xdylanm/low-pass-gate/README.md

# Low Pass Gate

Buchla-style VCA and Sallen-Key VCF with vactrols.
