xdylanm/low-pass-gate/docs/index.md

# Low Pass Gate

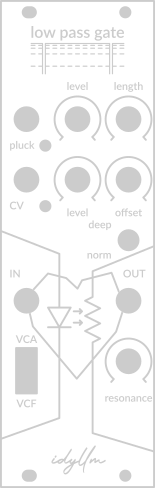
[picture p11: docs/assets/images/lpg-dark.png]

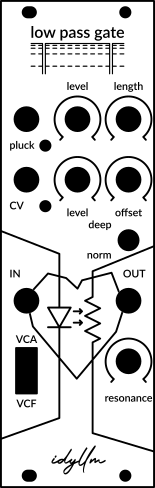
[picture p12: docs/assets/images/lpg-light.png]


Buchla-style VCA and Sallen-Key VCF with vactrols.

* Module size: 6HP (30mm)
* Power: 12mA (+12V); 12mA (-12V)

!!! repository "Project Source"

    The project files, including schematic and layout, are available on [github](https://github.com/xdylanm/low-pass-gate).

## Features

* Pluck input with manual controls for length and level
* CV input with manual controls for level and offset
* Resonance

## Documentation

* [Design](theory.md)
* [Assembly Guide](assembly.md)
* [Schematic](assets/lpg.pdf)

## References

1. A. Lanterman, "ECE4450 L27: Buchla Lowpass Gate," [Youtube](https://www.youtube.com/watch?v=NGz3dDnoVVk) (retrieved Sept. 2024)
2. E. Bergman, "Synthesizer Build Part 35 - Resonant Lopass Gate," [eddybergman.com](https://www.eddybergman.com/2020/10/synthesizer-build-part-35-resonant.html) (retrieved Sept. 2024)
3. T. White, "Resonant Lopass Gate Circuit Board Project," [naturalrhythmmusic.com](https://naturalrhythmmusic.com/lopass) (retrieved Sept. 2024)
