xdylanm/low-pass-gate/docs/assets/lpg.pdf

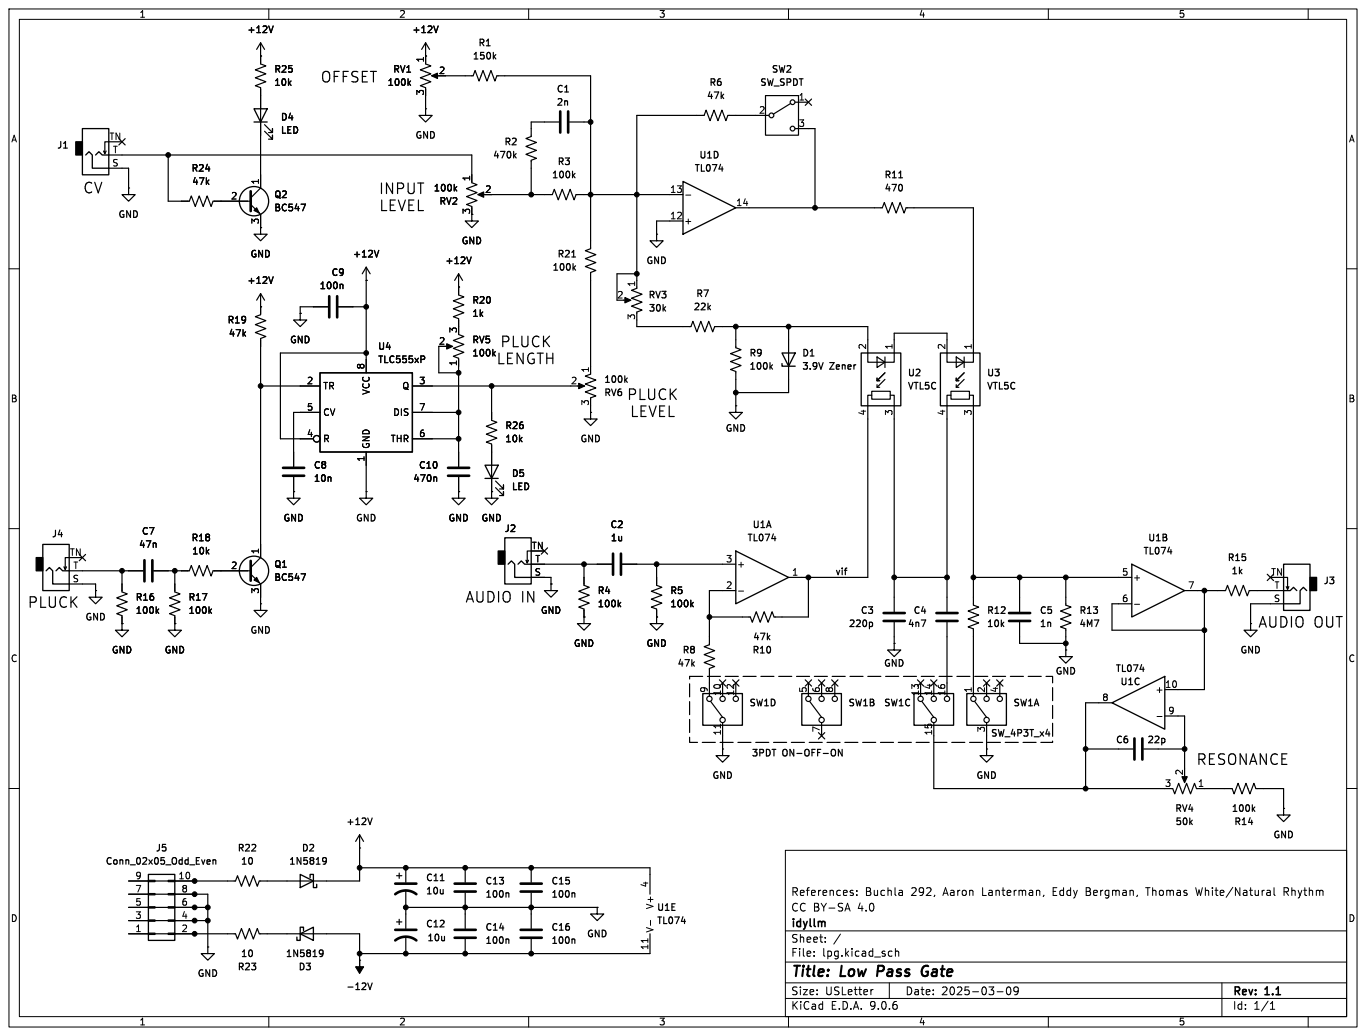
[picture p13: page 1]

CC BY-SA 4.0 References: idyllm | Buchla 292, Aaron | | Lanterman, | Eddy | Bergman, | Thomas White/Natural | Rhythm

E.D.A. 9.0.6 Size: USLetter Rev: 1.1 | D Date: 2025-03-09 KiCad

File: lpg.kicad_sch Sheet: /
Id: 1/1 Title: Low Pass Gate
