xdylanm/low-pass-gate/hardware/lpg/lpg.kicad_pcb

## KiCad design hardware/lpg/lpg.kicad_pcb (2025-04-30)

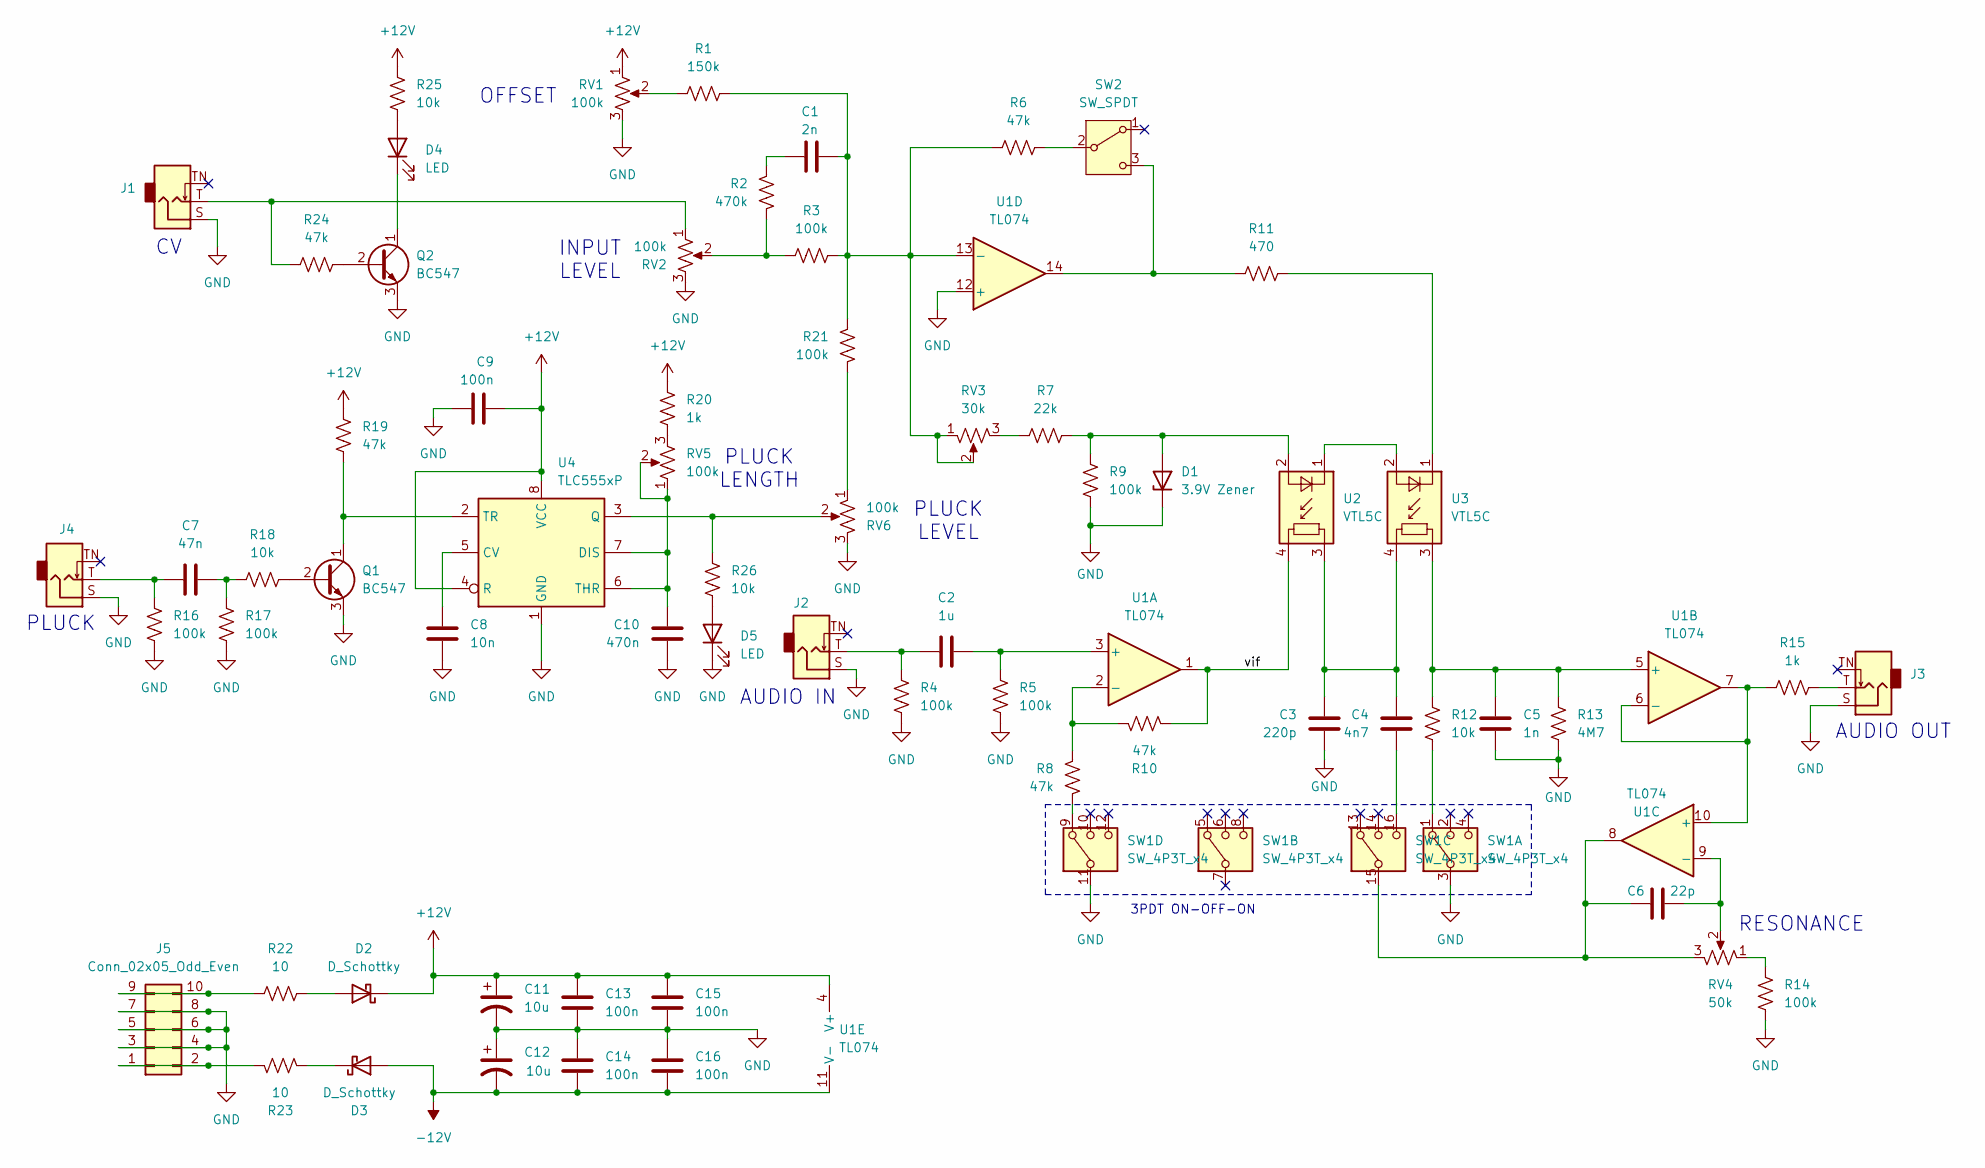
[picture p14: schematic lpg.kicad_sch, Low Pass Gate]

Parts:
C1: 2n; C_Disc_D5.0mm_W2.5mm_P2.50mm
C2: 1u; C_Disc_D5.0mm_W2.5mm_P2.50mm
C3: 220p; C_Disc_D5.0mm_W2.5mm_P2.50mm
C4: 4n7; C_Disc_D5.0mm_W2.5mm_P2.50mm
C5: 1n; C_Disc_D5.0mm_W2.5mm_P5.00mm
C6: 22p; C_Disc_D5.0mm_W2.5mm_P2.50mm
C7: 47n; C_Disc_D5.0mm_W2.5mm_P2.50mm
C8: 10n; C_Disc_D5.0mm_W2.5mm_P2.50mm
C9, C13, C14, C16: 100n; C_Disc_D5.0mm_W2.5mm_P2.50mm
C10: 470n; C_Disc_D5.0mm_W2.5mm_P2.50mm
C11, C12: 10u; CP_Radial_D5.0mm_P2.00mm
C15: 100n; C_Disc_D5.0mm_W2.5mm_P5.00mm
D1: 3.9V Zener; D_DO-35_SOD27_P2.54mm_Vertical_AnodeUp
D2, D3: D_Schottky; D_DO-41_SOD81_P2.54mm_Vertical_AnodeUp
D4, D5: LED; LED_D3.0mm
J1, J2, J3, J4: AudioJack2_SwitchT; Jack_3.5mm_QingPu_WQP-PJ301M-12_Vertical
J5: Conn_02x05_Odd_Even; IDC-Header_2x05_P2.54mm_Vertical
Q1, Q2: BC547; TO-92_Inline_Wide
R1: 150k; R_Axial_DIN0204_L3.6mm_D1.6mm_P2.54mm_Vertical
R2: 470k; R_Axial_DIN0204_L3.6mm_D1.6mm_P2.54mm_Vertical
R3, R4, R5, R9, R14, R16, R17, R21: 100k; R_Axial_DIN0204_L3.6mm_D1.6mm_P2.54mm_Vertical
R6, R8, R10, R19, R24: 47k; R_Axial_DIN0204_L3.6mm_D1.6mm_P2.54mm_Vertical
R7: 22k; R_Axial_DIN0204_L3.6mm_D1.6mm_P2.54mm_Vertical
R11: 470; R_Axial_DIN0207_L6.3mm_D2.5mm_P10.16mm_Horizontal
R12, R25: 10k; R_Axial_DIN0207_L6.3mm_D2.5mm_P15.24mm_Horizontal
R13: 4M7; R_Axial_DIN0204_L3.6mm_D1.6mm_P2.54mm_Vertical
R15, R20: 1k; R_Axial_DIN0204_L3.6mm_D1.6mm_P2.54mm_Vertical
R18, R26: 10k; R_Axial_DIN0204_L3.6mm_D1.6mm_P2.54mm_Vertical
R22, R23: 10; R_Axial_DIN0207_L6.3mm_D2.5mm_P2.54mm_Vertical
RV1, RV2, RV5, RV6: 100k; Potentiometer_Bourns_PTV09A-1_Single_Vertical
RV3: 30k; Potentiometer_Piher_PT-6-V_Vertical
RV4: 50k; Potentiometer_Bourns_PTV09A-1_Single_Vertical
SW1: SW_4P3T_x4; SW_4P3T_SS-43D01_NoFrame
SW2: SW_SPDT; SW_Dailywell_SPDT_2MS1T1B1M1
U1: TL074; DIP-14_W7.62mm_Socket
U2, U3: VTL5C; PerkinElmer_VTL5C
U4: TLC555xP; DIP-8_W7.62mm_Socket

Connections:
+12V: C9.1, C11.1, C13.2, C15.2, D2.1 (K), R19.1, R20.1, R25.2, RV1.1, U1.4 (V+), U4.4 (R), U4.8 (VCC)
-12V: C12.2, C14.1, C16.1, D3.2 (A), U1.11 (V-)
/vif: R10.2, U1.1, U2.4
GND: C3.1, C5.1, C8.1, C9.2, C10.1, C11.2, C12.1, C13.1, C14.2, C15.1, C16.2, D1.1 (K), D5.1 (K), J1.S, J2.S, J3.S, J4.S, J5.3, J5.4, J5.5, J5.6, J5.7, J5.8, Q1.3 (E), Q2.3 (E), R4.1, R5.1, R9.2, R13.2, R14.2, R16.1, R17.1, RV1.3, RV2.3, RV6.3, SW1.3, SW1.11, U1.12 (+), U4.1 (GND)
unnamed: C1.1, R2.1
unnamed: C2.1, J2.T, R4.2
unnamed: C3.2, C4.2, U2.3, U3.4
unnamed: C4.1, SW1.16
unnamed: C6.2, RV4.3, SW1.15, U1.8
unnamed: C7.1, J4.T, R16.2
unnamed: C7.2, R17.2, R18.2
unnamed: D1.2 (A), R7.1, R9.1, U2.2 (+)
unnamed: D2.2 (A), R22.1
unnamed: D3.1 (K), R23.1
unnamed: D4.2 (A), R25.1
unnamed: D4.1 (K), Q2.1 (C)
unnamed: D5.2 (A), R26.1
unnamed: J1.T, R24.1, RV2.1
unnamed: J3.T, R15.2
unnamed: J5.1, J5.2, R23.2
unnamed: J5.9, J5.10, R22.2
unnamed: Q1.2 (B), R18.1
unnamed: Q1.1 (C), R19.2, U4.2 (TR)
unnamed: Q2.2 (B), R24.2
unnamed: R1.2, RV1.2
unnamed: R2.2, R3.2, RV2.2
unnamed: R7.2, RV3.3
unnamed: R8.2, SW1.9
unnamed: R12.2, SW1.1
unnamed: R14.1, RV4.1
unnamed: R20.2, RV5.3
unnamed: R21.2, RV6.1
unnamed: R6.1, SW2.2 (B)
unnamed: R11.2, SW2.3 (C), U1.14
unnamed: C2.2, R5.2, U1.3 (+)
unnamed: R8.1, R10.1, U1.2 (-)
unnamed: C5.2, R12.1, R13.1, U1.5 (+), U3.3
unnamed: R15.1, U1.6 (-), U1.7, U1.10 (+)
unnamed: C6.1, RV4.2, U1.9 (-)
unnamed: C1.2, R1.1, R3.1, R6.2, R21.1, RV3.1, RV3.2, U1.13 (-)
unnamed: U2.1 (-), U3.2 (+)
unnamed: R11.1, U3.1 (-)
unnamed: C8.2, U4.5 (CV)
unnamed: C10.2, RV5.1, RV5.2, U4.6 (THR), U4.7 (DIS)
unnamed: R26.2, RV6.2, U4.3 (Q)

Notes on the sheet:
RESONANCE
INPUT LEVEL
AUDIO IN
3PDT ON-OFF-ON
PLUCK
PLUCK LEVEL
AUDIO OUT
PLUCK LENGTH
OFFSET

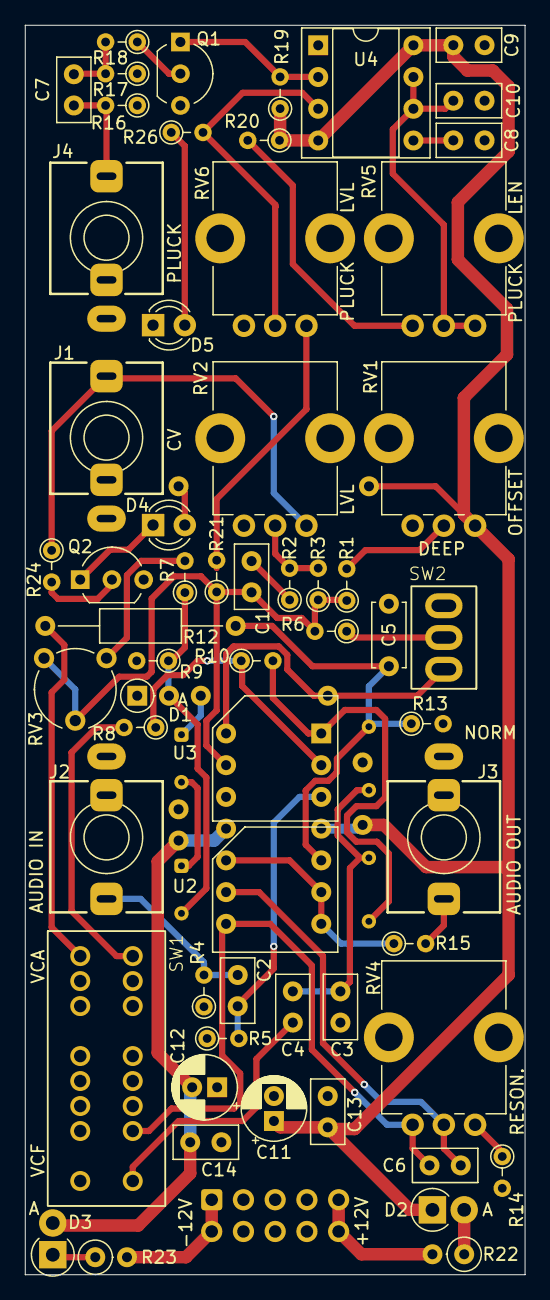
[picture p15: board lpg.kicad_pcb from above]

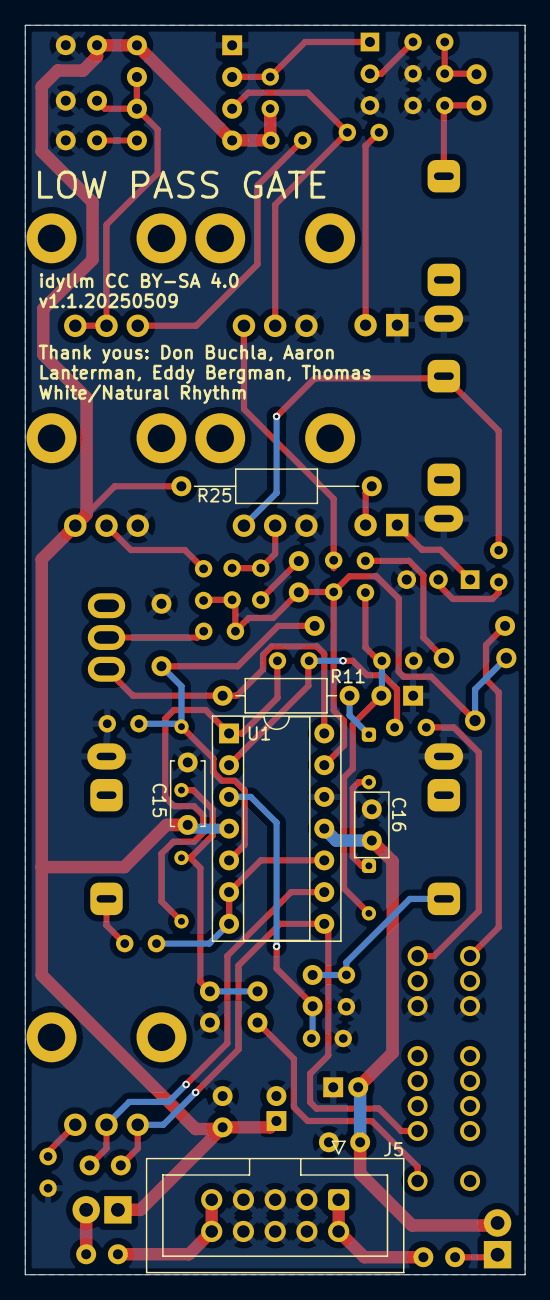
[picture p16: board lpg.kicad_pcb from below]

Board: 2 copper layers, 40.0 x 100.0 mm, 66 parts (6 on the bottom side), 45 nets.
