xdylanm/low-pass-gate/(commit log)

2024-10-03 Initial version of circuit and PCB for fabrication
    [lpg.kicad_pcb, lpg.kicad_sch, sketches.kicad_sch]
2025-03-10 replaced switches with 4P3T slider and SPDT M5 sub-mini toggle
    [lpg.kicad_pcb, lpg.kicad_sch]
2025-03-10 boards for v1.1
    [lpg.kicad_pcb]
2025-04-30 Faceplate layout and silkscreen
    [lpg.kicad_pcb, lpg.kicad_sch, lpg_faceplate.kicad_pcb, lpg_faceplate.kicad_sch]
2026-05-26 Update KiCad project settings and error handling parameters
    - Added new error handling for "creepage", "hole_to_hole", "text_on_edge_cuts", "track_angle", and "track_segment_length".
    - Set "footprint_filters_mismatch" and "footprint_type_mismatch" to "ignore".
    - Updated teardrop options to include "td_onpthpad" and "td_onsmdpad".
    - Introduced "min_groove_width" parameter.
    - Adjusted version numbers in meta information.
    - Added "priority" field to net settings.
    [lpg.kicad_sch]
2026-05-26 Add documentation for Low Pass Gate module and remove legacy files
    - Created index.md for module overview and features.
    - Removed make.bat and assembly.md as part of documentation cleanup.
    - Added arithmatex-config.js for MathJax configuration.
    - Deleted conf.py, index.rst, and requirements.txt to streamline documentation setup.
    - Introduced extra.css for custom styles and improved visual elements.
    - Added theory.md detailing the design and functionality of the Sallen-Key filter and Buchla 292 style low-pass gate.
    - Set up mkdocs.yml for new documentation structure and navigation.
    - Added SVG icons for the documentation theme.
    - Created requirements.txt for project dependencies.
    [bom.csv]
