xdylanm/low-pass-gate/(notices)

Notices in the files:
hardware/lpg/lpg.kicad_pcb:
idyllm CC BY-SA 4.0
